alexDickhans/ucap/ucap/production/ucap-bom.csv

Designator | Comment | Footprint | Qty | LCSC Part #
C1,C16,C18,C20,C22 | 4u7 | Capacitor_SMD:C_0603_1608Metric | 5 | C19666
C2 | 22u | Capacitor_SMD:C_1206_3216Metric | 1 | C12891
C3 | 10u | Capacitor_SMD:C_0805_2012Metric | 1 | C15850
C4,C6 | 22u | Capacitor_SMD:C_0805_2012Metric | 2 | C45783
C5 | 10n | Capacitor_SMD:C_0402_1005Metric | 1 | C1524
C7,C8,C10,C11,C12,C15,C17,C19,C21,C23,C24 | 100n | Capacitor_SMD:C_0402_1005Metric | 11 | C1525
C9,C13,C14 | 1u | Capacitor_SMD:C_0402_1005Metric | 3 | C52923
D1 | STAT | LED_SMD:LED_0805_2012Metric | 1 | C2297
D2 | SD05C-01FTG | Diode_SMD:D_SOD-323 | 1 | C118264
FB1 | 600 @ 100MHz | Inductor_SMD:L_0603_1608Metric | 1 | C1002
J1 | USB_C_Receptacle_USB2.0_14P | Connector_USB:USB_C_Receptacle_Molex_105450-0101 | 1 | C134092
J2 | Conn_01x03_Pin | Connector_JST:JST_SH_BM03B-SRSS-TB_1x03-1MP_P1.00mm_Vertical | 1 | C160389
J3,J4,J5,J6 | Conn_01x04_Socket | Connector_JST:JST_SH_BM04B-SRSS-TB_1x04-1MP_P1.00mm_Vertical | 4 | C160390
L1 | 2u2 | Inductor_SMD:L_APV_ANR4020 | 1 | C98361
R1,R2 | 5k1 | Resistor_SMD:R_0402_1005Metric | 2 | C25905
R3 | 33.2k | Resistor_SMD:R_0402_1005Metric | 1 | C122548
R4,R7,R8,R10,R11 | 10k | Resistor_SMD:R_0402_1005Metric | 5 | C25744
R5 | 1M | Resistor_SMD:R_0402_1005Metric | 1 | C26083
R6 | 220 | Resistor_SMD:R_0402_1005Metric | 1 | C25091
R9 | 470 | Resistor_SMD:R_0402_1005Metric | 1 | C25117
TP3 | GND | TestPoint:TestPoint_Pad_D2.0mm | 1
TP4 | 3v3 | TestPoint:TestPoint_Pad_D2.0mm | 1
U1 | STM32G474CEUx | Package_DFN_QFN:QFN-48-1EP_7x7mm_P0.5mm_EP5.6x5.6mm | 1 | C1235412
U2 | USBLC6-2SC6 | Package_TO_SOT_SMD:SOT-23-6 | 1 | C7519
U3 | TPS563208 | Package_TO_SOT_SMD:SOT-23-6 | 1 | C468250
