alexDickhans/ucap/ucap/ucap.kicad_pcb

## KiCad design ucap/ucap.kicad_pcb (2026-11-06)

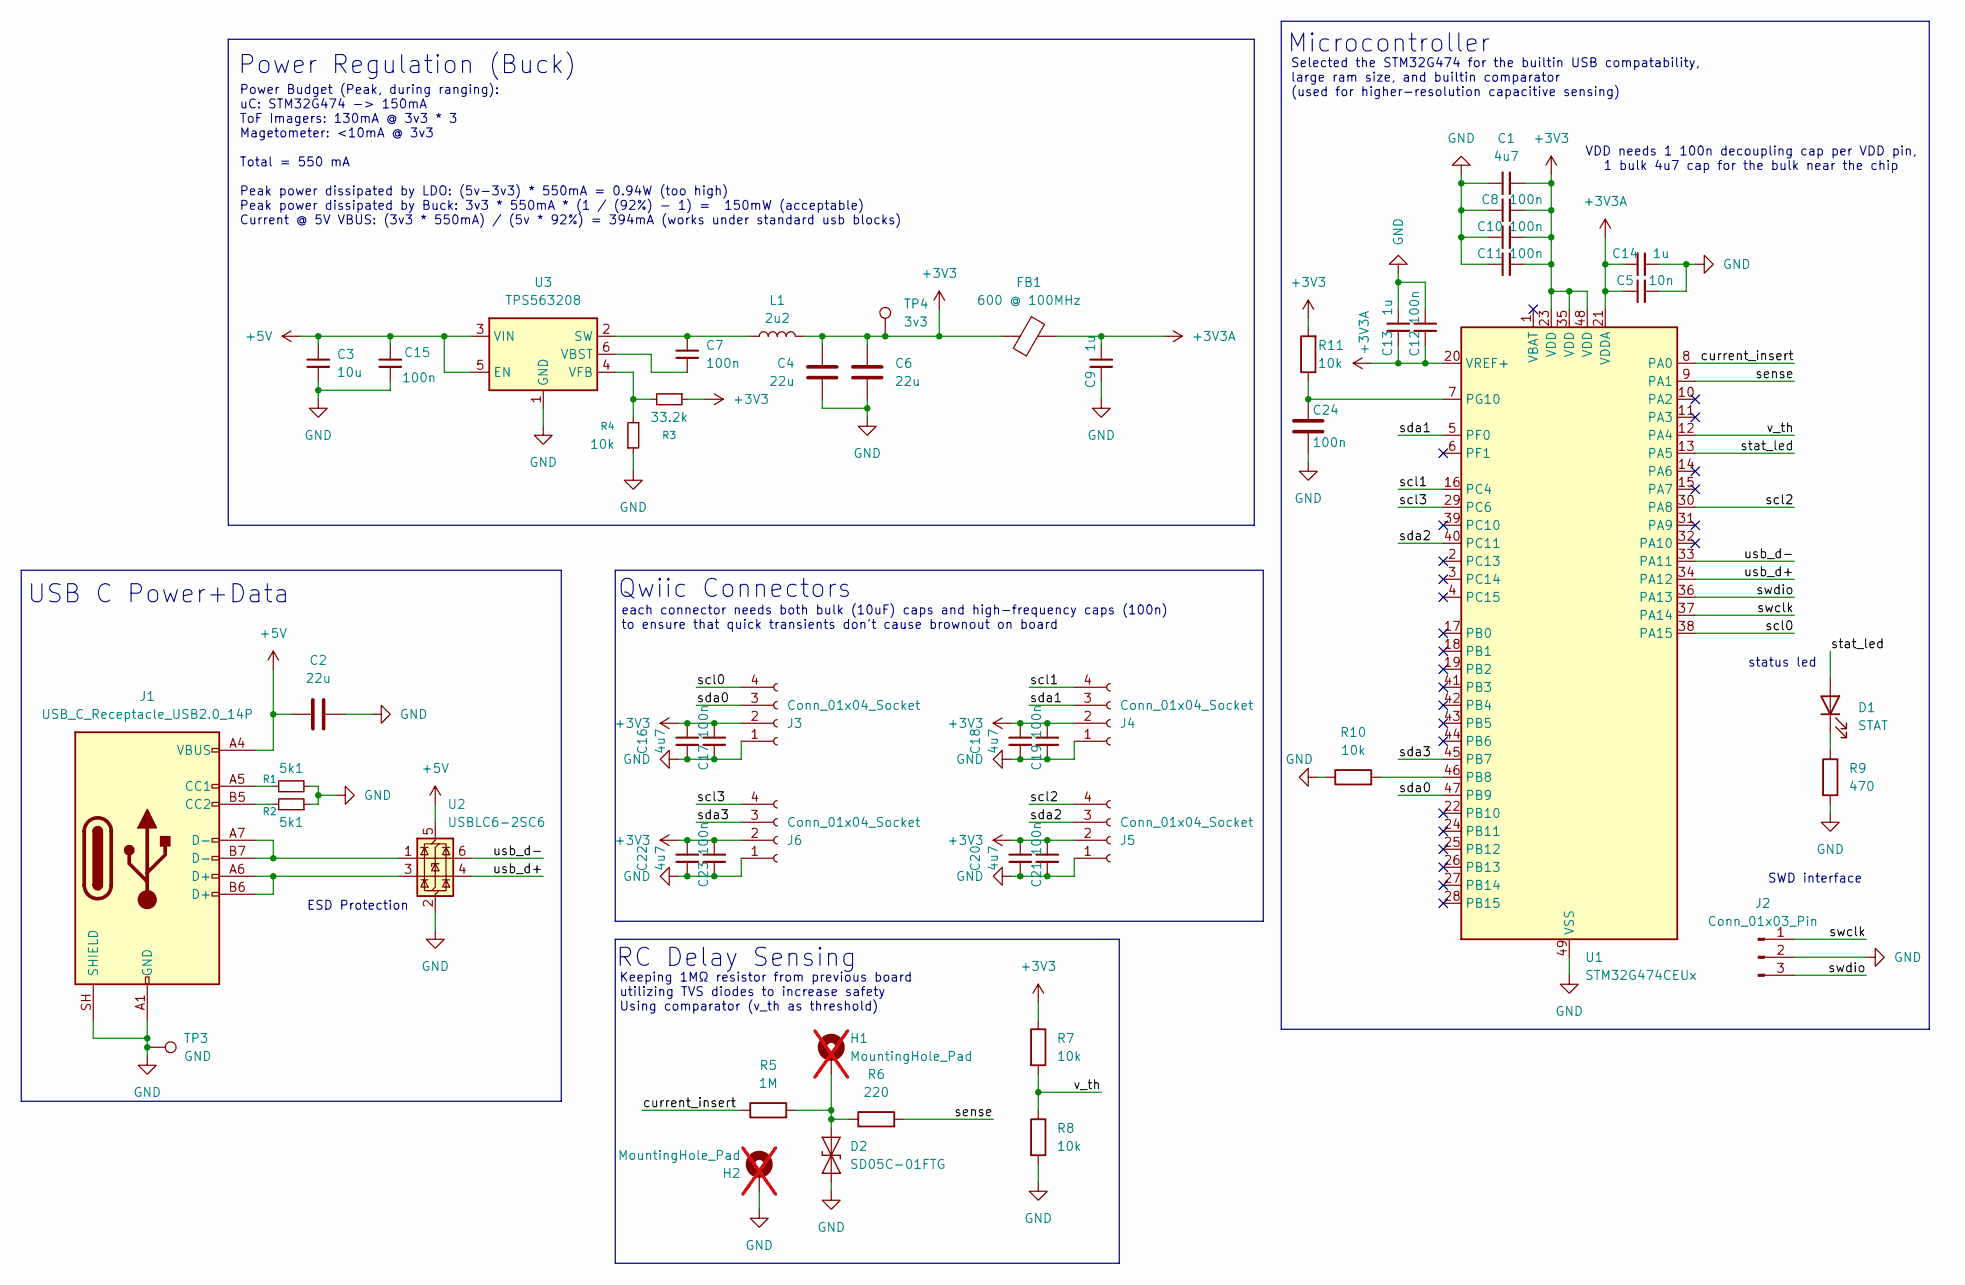
[picture p9: schematic ucap.kicad_sch]

Parts:
C1, C16, C18, C20, C22: 4u7; C_0603_1608Metric; LCSC Part # C19666
C2: 22u; C_1206_3216Metric; LCSC Part # C12891
C3: 10u; C_0805_2012Metric; LCSC Part # C15850
C4, C6: 22u; C_0805_2012Metric; LCSC Part # C45783
C5: 10n; C_0402_1005Metric; LCSC Part # C1524
C7, C8, C10, C11, C12, C15, C17, C19, C21, C23, C24: 100n; C_0402_1005Metric; LCSC Part # C1525
C9, C13, C14: 1u; C_0402_1005Metric; LCSC Part # C52923
D1: STAT; LED_0805_2012Metric; LCSC Part # C2297
D2: SD05C-01FTG; D_SOD-323; LCSC Part # C118264
FB1: 600 @ 100MHz; L_0603_1608Metric; LCSC Part # C1002
H1, H2: MountingHole_Pad; MountingHole_2.2mm_M2_DIN965_Pad; not fitted
J1: USB_C_Receptacle_USB2.0_14P; USB_C_Receptacle_Molex_105450-0101; LCSC Part # C134092
J2: Conn_01x03_Pin; JST_SH_BM03B-SRSS-TB_1x03-1MP_P1.00mm_Vertical; LCSC Part # C160389
J3, J4, J5, J6: Conn_01x04_Socket; JST_SH_BM04B-SRSS-TB_1x04-1MP_P1.00mm_Vertical; LCSC Part # C160390
L1: 2u2; L_APV_ANR4020; LCSC Part # C98361
R1, R2: 5k1; R_0402_1005Metric; LCSC Part # C25905
R3: 33.2k; R_0402_1005Metric; LCSC Part # C122548
R4, R7, R8, R10, R11: 10k; R_0402_1005Metric; LCSC Part # C25744
R5: 1M; R_0402_1005Metric; LCSC Part # C26083
R6: 220; R_0402_1005Metric; LCSC Part # C25091
R9: 470; R_0402_1005Metric; LCSC Part # C25117
TP3: GND; TestPoint_Pad_D2.0mm
TP4: 3v3; TestPoint_Pad_D2.0mm
U1: STM32G474CEUx; QFN-48-1EP_7x7mm_P0.5mm_EP5.6x5.6mm; LCSC Part # C1235412
U2: USBLC6-2SC6; SOT-23-6; LCSC Part # C7519
U3: TPS563208; SOT-23-6; LCSC Part # C468250

Connections:
+3V3: C1.2, C4.2, C6.2, C8.2, C10.2, C11.2, C16.2, C17.2, C18.2, C19.2, C20.2, C21.2, C22.2, C23.2, FB1.1, J3.2, J4.2, J5.2, J6.2, L1.2, R3.1, R7.1, R11.2, TP4.1 (1_1), U1.23 (VDD), U1.35 (VDD), U1.48 (VDD)
+3V3A: C5.1, C9.2, C12.1, C13.1, C14.1, FB1.2, U1.20 (VREF+), U1.21 (VDDA)
+5V: C2.2, C3.1, C15.2, J1.A4 (VBUS), J1.A9 (VBUS), J1.B4 (VBUS), J1.B9 (VBUS), U2.5 (VBUS), U3.3 (VIN), U3.5 (EN)
/current_insert: R5.1, U1.8 (PA0)
/scl0: J3.4, U1.38 (PA15)
/scl1: J4.4, U1.16 (PC4)
/scl2: J5.4, U1.30 (PA8)
/scl3: J6.4, U1.29 (PC6)
/sda0: J3.3, U1.47 (PB9)
/sda1: J4.3, U1.5 (PF0)
/sda2: J5.3, U1.40 (PC11)
/sda3: J6.3, U1.45 (PB7)
/sense: R6.2, U1.9 (PA1)
/stat_led: D1.2 (A), U1.13 (PA5)
/swclk: J2.1, U1.37 (PA14)
/swdio: J2.3, U1.36 (PA13)
/usb_d+: U1.34 (PA12), U2.4 (I/O2)
/usb_d-: U1.33 (PA11), U2.6 (I/O1)
/v_th: R7.2, R8.1, U1.12 (PA4)
GND: C1.1, C2.1, C3.2, C4.1, C5.2, C6.1, C8.1, C9.1, C10.1, C11.1, C12.2, C13.2, C14.2, C15.1, C16.1, C17.1, C18.1, C19.1, C20.1, C21.1, C22.1, C23.1, C24.2, D2.2 (A2), H2.1 (1_1), J1.A1 (GND), J1.A12 (GND), J1.B1 (GND), J1.B12 (GND), J1.SH (SHIELD), J2.2, J3.1, J4.1, J5.1, J6.1, R1.2, R2.1, R4.1, R8.2, R9.2, R10.1, TP3.1 (1_1), U1.49 (VSS), U2.2 (GND), U3.1 (GND)
unnamed: D1.1 (K), R9.1
unnamed: D2.1 (A1), H1.1 (1_1), R5.2, R6.1
unnamed: J1.A5 (CC1), R1.1
unnamed: J1.B5 (CC2), R2.2
unnamed: J1.A6 (D+), J1.B6 (D+), U2.3 (I/O2)
unnamed: J1.A7 (D-), J1.B7 (D-), U2.1 (I/O1)
unnamed: R10.2, U1.46 (PB8)
unnamed: C24.1, R11.1, U1.7 (PG10)
unnamed: C7.1, L1.1, U3.2 (SW)
unnamed: C7.2, U3.6 (VBST)
unnamed: R3.2, R4.2, U3.4 (VFB)

Notes on the sheet:
status led
each connector needs both bulk (10uF) caps and high-frequency caps (100n) to ensure that quick transients don't cause brownout on board
Power Budget (Peak, during ranging): uC: STM32G474 -> 150mA ToF Imagers: 130mA @ 3v3 * 3 Magetometer: <10mA @ 3v3 Total = 550 mA Peak power dissipated by LDO: (5v-3v3) * 550mA = 0.94W (too high) Peak power dissipated by Buck: 3v3 * 550mA * (1 / (92%) - 1) = 150mW (acceptable) Current @ 5V VBUS: (3v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
Microcontroller
SWD interface
ESD Protection
Power Regulation (Buck)
Qwiic Connectors
RC Delay Sensing
Selected the STM32G474 for the builtin USB compatability, large ram size, and builtin comparator (used for higher-resolution capacitive sensing)
USB C Power+Data
Keeping 1MΩ resistor from previous board utilizing TVS diodes to increase safety Using comparator (v_th as threshold)
VDD needs 1 100n decoupling cap per VDD pin, 1 bulk 4u7 cap for the bulk near the chip

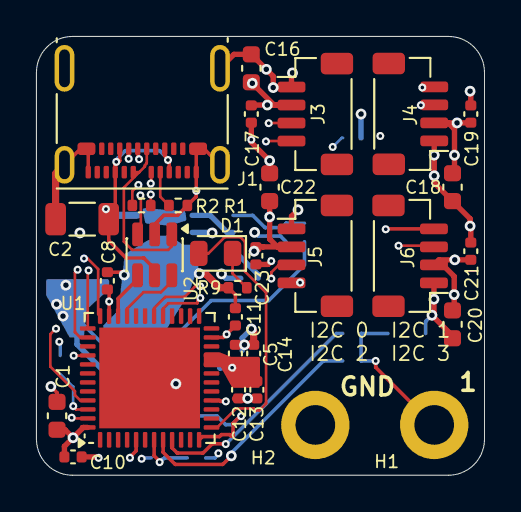
[picture p10: board ucap.kicad_pcb from above]

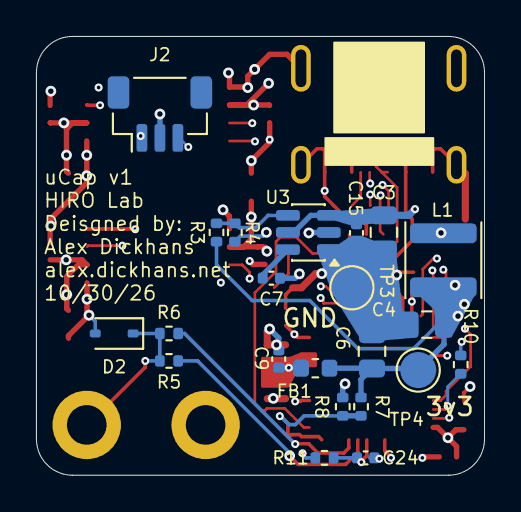
[picture p11: board ucap.kicad_pcb from below]

Board: 6 copper layers, 24.9 x 24.4 mm, 52 parts (22 on the bottom side), 31 nets.
