alexDickhans/ucap/(commit log)

2026-11-02 Remove stuff in gitignore from repo
    [bom.csv, designators.csv, positions.csv]
2026-11-02 Move ucap kicad project
    [ucap.kicad_pcb, ucap.kicad_sch]
2026-11-02 Remove base level kicad repo
    [microcap.kicad_pcb, microcap.kicad_sch]
2026-11-06 Document uCap v1 and replace the stale fabrication outputs
    The checked-in gerber zip and IPC netlist were the older microcap job, with drill maps and an empty NPTH file. Export gerbers, drill, BOM, and placement from this board. Correct the microcontroller and TVS LCSC numbers so they match the symbols.
    [ucap-bom.csv, ucap.kicad_pcb, ucap.kicad_sch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]
